dczia/Defcon25-Badge/README.md

## DC-Zia 2017
Badge - Arduino 101 Shield with LCD Display, Neopixel Lights and Cherry MX Blue Keyboard Buttons
