dczia/Defcon25-Badge/MechKeyboardShield/Hardware/Solid Model/dczia-badge.SLDASM

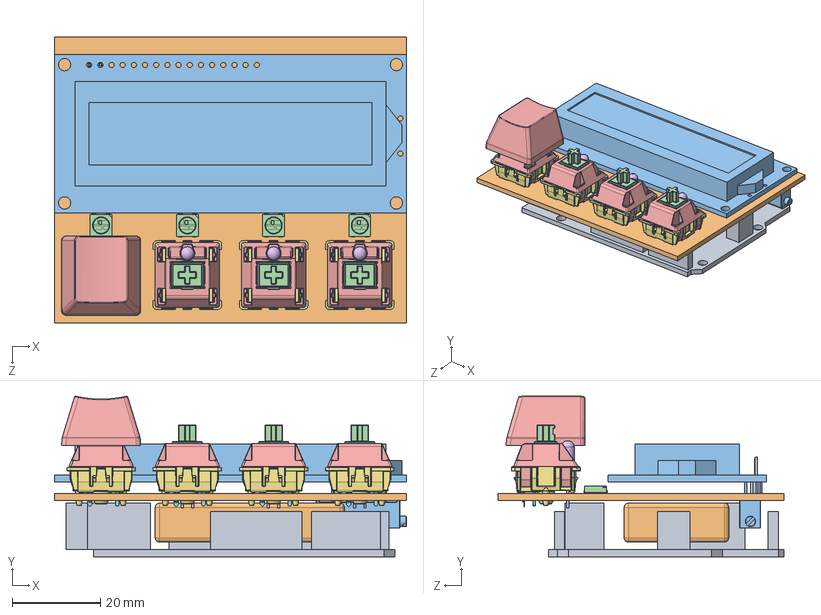
[picture p1: CAD file, 2017-08-07]
MechKeyboardShield/Hardware/Solid Model/dczia-badge.SLDASM
80.0 x 36.5 x 65.0 mm
MX 轴 按键 x 4
MX 轴 轴体 x 4
MX轴 无帽LED x 4
MX轴 轴体 底部 x 4
针脚 x 4
WS2812b Updated x 4
