dczia/Defcon25-Badge/MechKeyboardShield/Hardware/Solid Model/Parts/machanical-keyboard-keys-mx-key-switches-mx/MX 按键.SLDASM

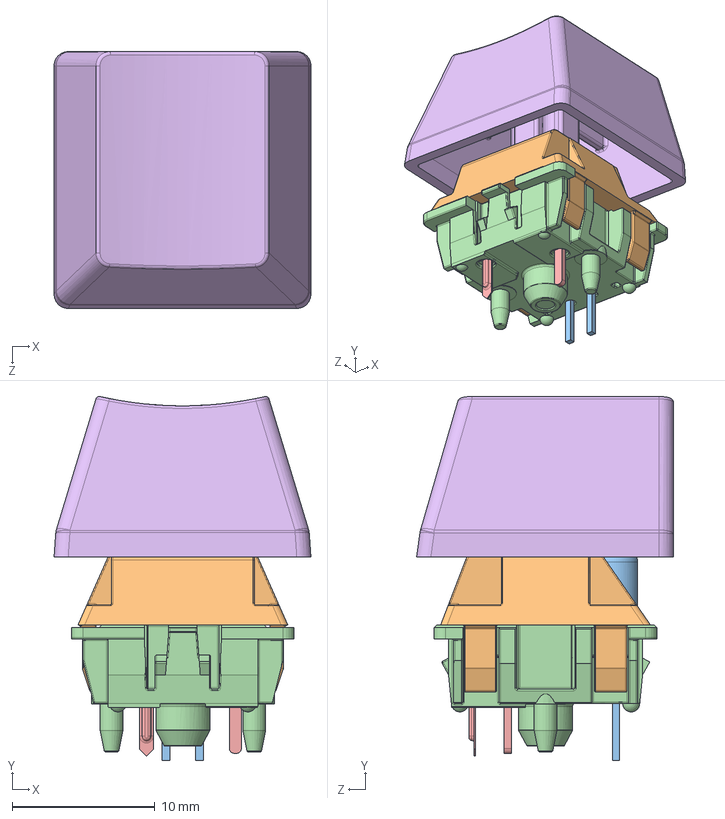
[picture p2: CAD file, 2017-08-07]
MechKeyboardShield/Hardware/Solid Model/Parts/machanical-keyboard-keys-mx-key-switches-mx/MX 按键.SLDASM
18.0 x 25.5 x 18.0 mm
MX 轴 按键
MX 轴 轴体
MX轴 无帽LED
MX轴 轴体 底部
针脚
MX 轴标准键帽
