dczia/Defcon25-Badge/MechKeyboardShield/Hardware/Overlay/Overlay.SLDPRT

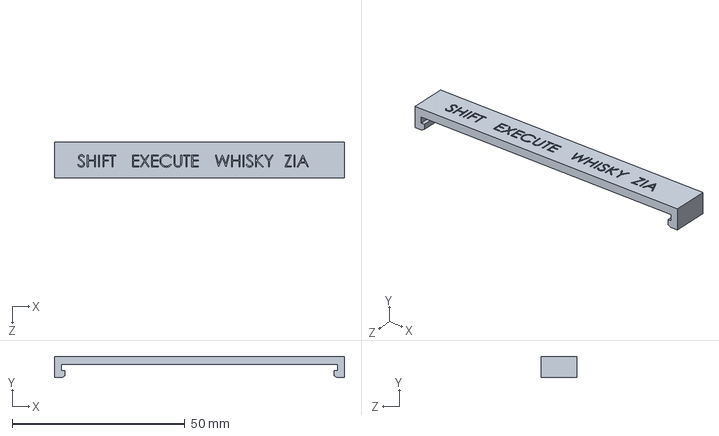
[picture p3: CAD file, 2017-08-07]
MechKeyboardShield/Hardware/Overlay/Overlay.SLDPRT
84.0 x 6.15 x 10.5 mm
