dczia/Defcon25-Badge/MechKeyboardShield/Hardware/Solid Model/Parts/1602 Display.SLDPRT

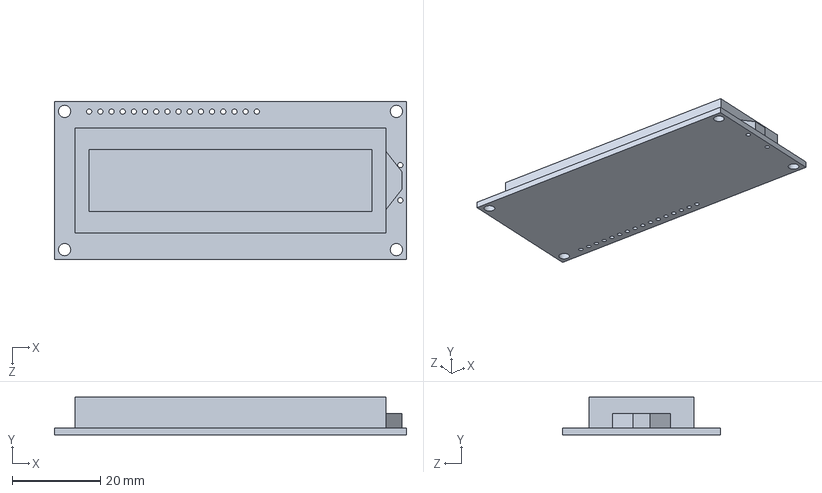
[picture p4: CAD file, 2017-08-07]
MechKeyboardShield/Hardware/Solid Model/Parts/1602 Display.SLDPRT
80.0 x 8.60 x 36.0 mm
