dczia/Defcon25-Badge/MechKeyboardShield/Hardware/Solid Model/Parts/machanical-keyboard-keys-mx-key-switches-mx/MX轴 无帽LED.SLDPRT

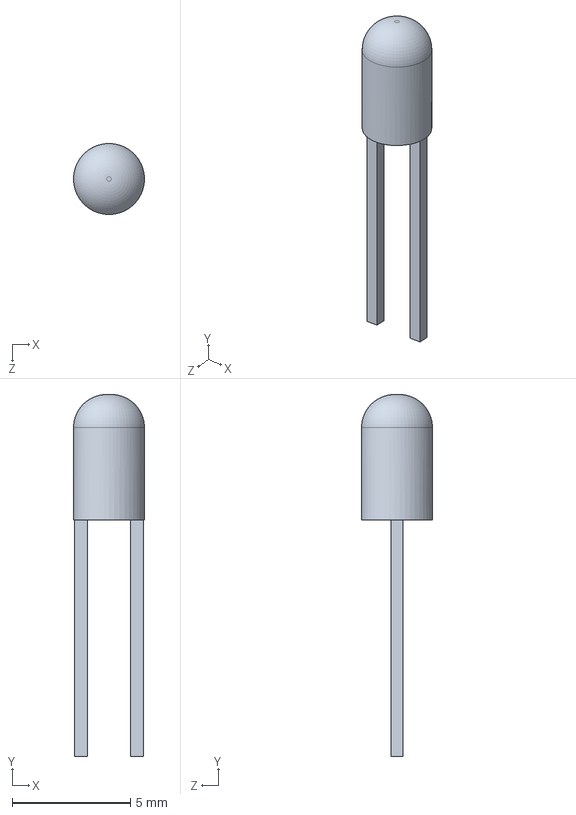
[picture p5: CAD file, 2017-08-07]
MechKeyboardShield/Hardware/Solid Model/Parts/machanical-keyboard-keys-mx-key-switches-mx/MX轴 无帽LED.SLDPRT
3.00 x 15.3 x 3.00 mm
