dczia/Defcon25-Badge/MechKeyboardShield/Hardware/Solid Model/Parts/standard-keycap-accurate-mx-keys/MX 轴标准键帽.STEP

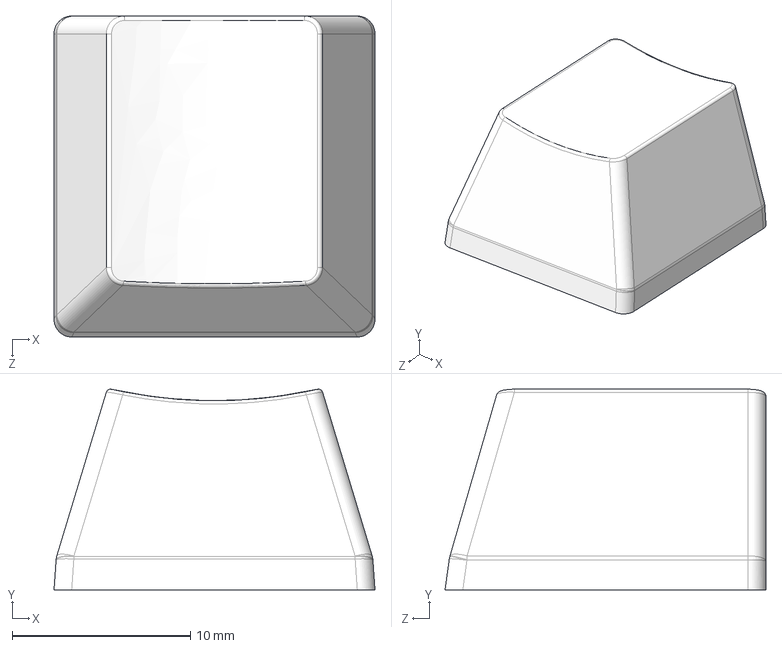
[picture p6: CAD file, 2017-08-07]
MechKeyboardShield/Hardware/Solid Model/Parts/standard-keycap-accurate-mx-keys/MX 轴标准键帽.STEP
18.0 x 11.3 x 18.0 mm
