dczia/Defcon25-Badge/MechKeyboardShield/Hardware/Solid Model/Parts/ws2812b-rgb-led-adafruit-neopixel/WS2812_RGB_LED_updated.stp

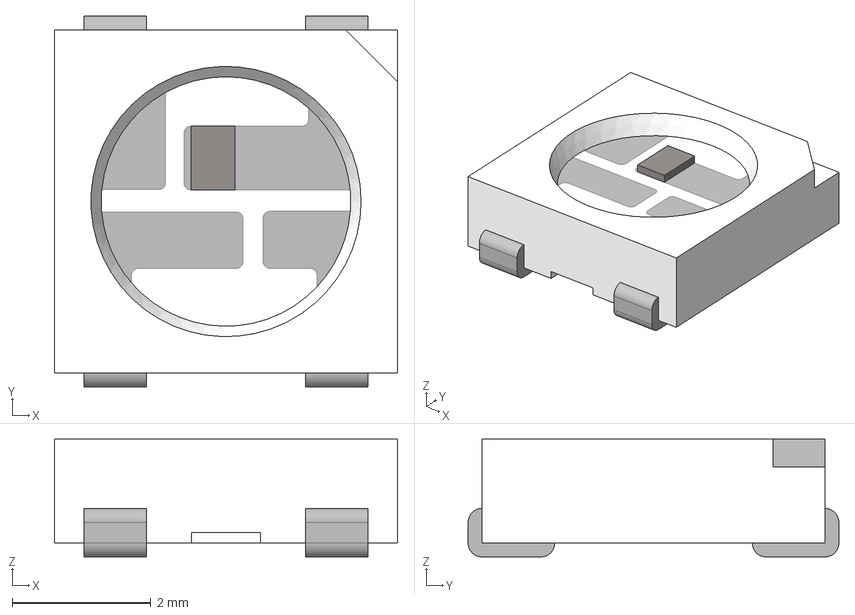
[picture p7: CAD file, 2017-08-07]
MechKeyboardShield/Hardware/Solid Model/Parts/ws2812b-rgb-led-adafruit-neopixel/WS2812_RGB_LED_updated.stp
4.95 x 5.35 x 1.70 mm
