dczia/Defcon25-Badge/MechKeyboardShield/Hardware/Solid Model/ButtonHolder.SLDPRT

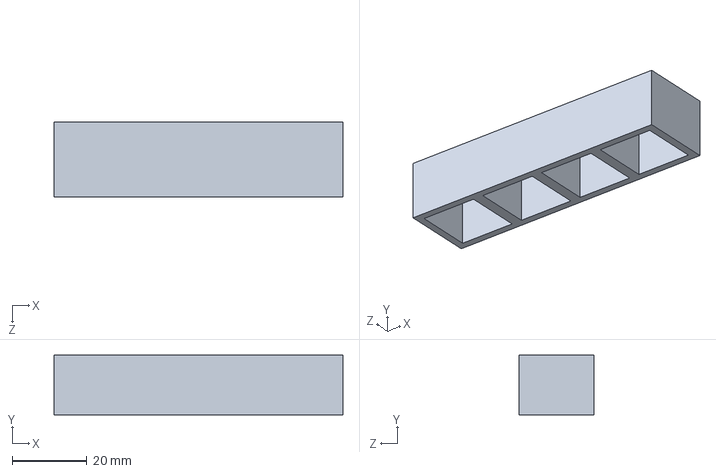
[picture p8: CAD file, 2017-08-07]
MechKeyboardShield/Hardware/Solid Model/ButtonHolder.SLDPRT
77.2 x 16.0 x 20.0 mm
