dczia/Defcon25-Badge/MechKeyboardShield/Hardware/Solid Model/Parts/2.54X2_pinheader_male.SLDPRT

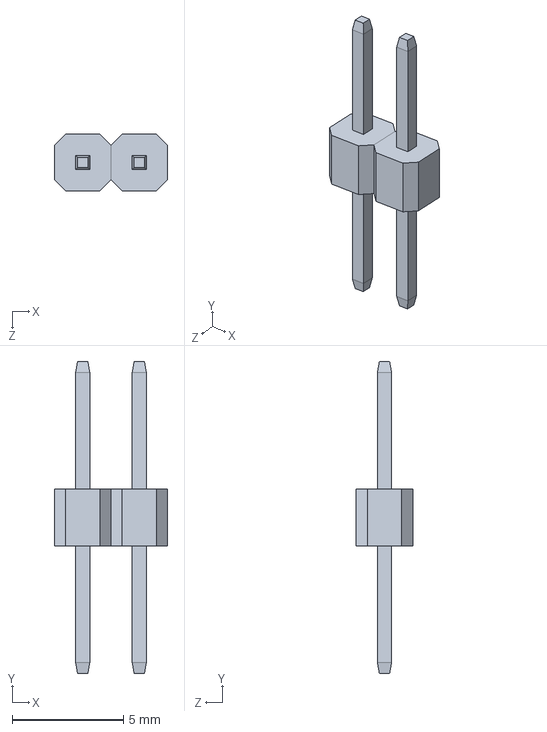
[picture p9: CAD file, 2017-08-07]
MechKeyboardShield/Hardware/Solid Model/Parts/2.54X2_pinheader_male.SLDPRT
5.08 x 14.0 x 2.54 mm
