dczia/Defcon25-Badge/MechKeyboardShield/Hardware/Solid Model/Parts/ws2812b-rgb-led-adafruit-neopixel/WS2812b Updated.sldprt

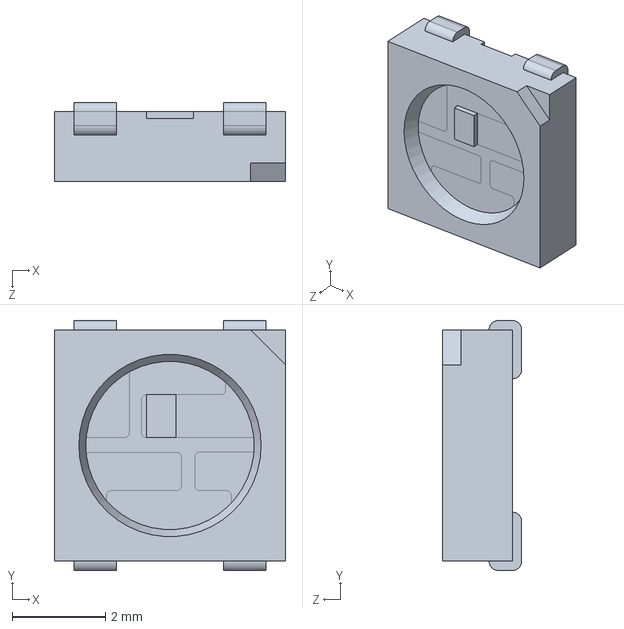
[picture p10: CAD file, 2017-08-07]
MechKeyboardShield/Hardware/Solid Model/Parts/ws2812b-rgb-led-adafruit-neopixel/WS2812b Updated.sldprt
4.95 x 5.35 x 1.70 mm
