dczia/Defcon25-Badge/MechKeyboardShield/Hardware/Solid Model/Parts/arduino-101.SLDPRT

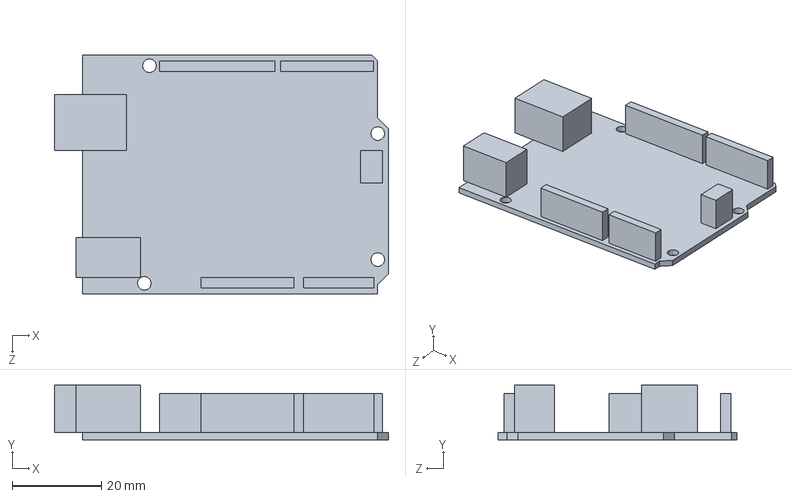
[picture p11: CAD file, 2017-08-07]
MechKeyboardShield/Hardware/Solid Model/Parts/arduino-101.SLDPRT
74.8 x 12.2 x 53.5 mm
