dczia/Defcon25-Badge/MechKeyboardShield/Hardware/Solid Model/Parts/machanical-keyboard-keys-mx-key-switches-mx/MX轴 轴体 底部.SLDPRT

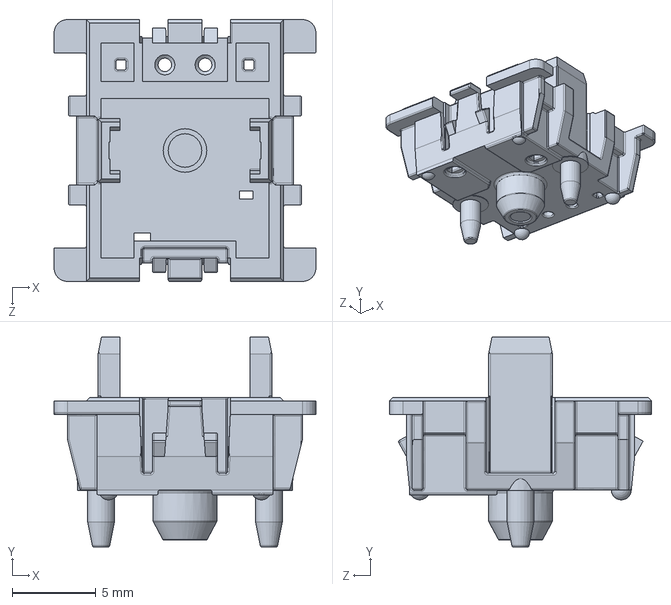
[picture p12: CAD file, 2017-08-07]
MechKeyboardShield/Hardware/Solid Model/Parts/machanical-keyboard-keys-mx-key-switches-mx/MX轴 轴体 底部.SLDPRT
15.6 x 12.5 x 15.6 mm
