dczia/Defcon25-Badge/MechKeyboardShield/Hardware/Solid Model/Parts/3P_TrimPot.stp

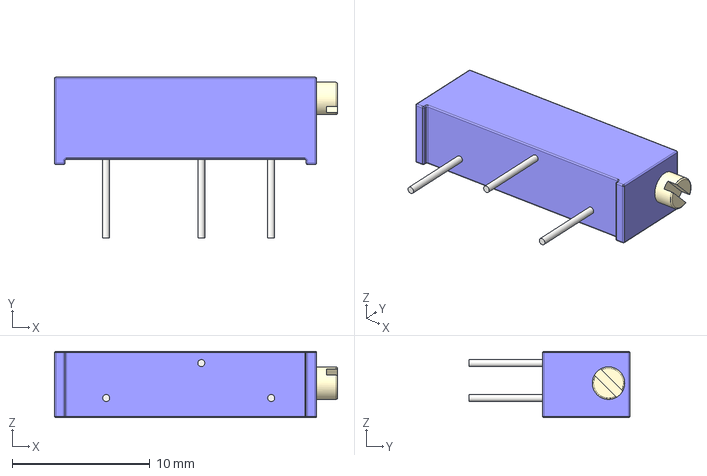
[picture p13: CAD file, 2017-08-07]
MechKeyboardShield/Hardware/Solid Model/Parts/3P_TrimPot.stp
20.6 x 11.7 x 4.83 mm
