dczia/Defcon25-Badge/MechKeyboardShield/Hardware/Solid Model/Parts/machanical-keyboard-keys-mx-key-switches-mx/MX 轴 轴体.SLDPRT

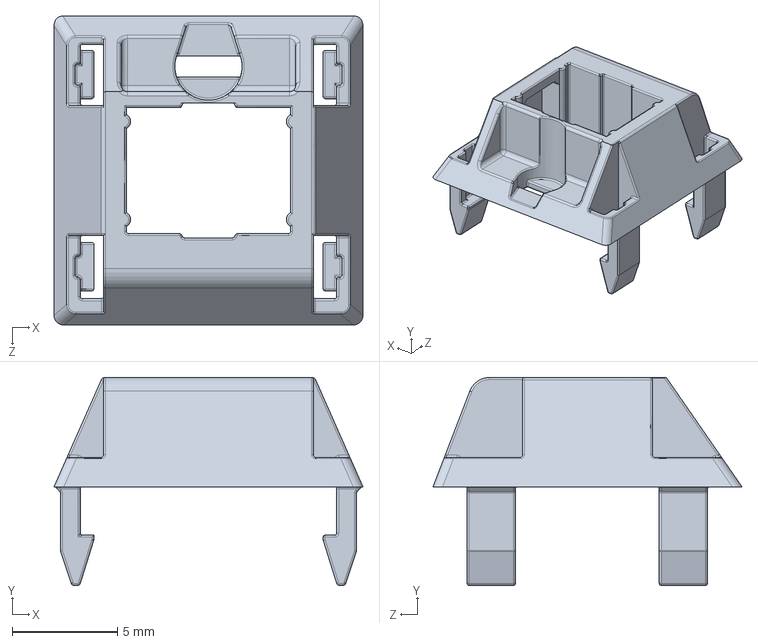
[picture p14: CAD file, 2017-08-07]
MechKeyboardShield/Hardware/Solid Model/Parts/machanical-keyboard-keys-mx-key-switches-mx/MX 轴 轴体.SLDPRT
14.7 x 9.90 x 14.7 mm
