dczia/Defcon25-Badge/MechKeyboardShield/Hardware/Solid Model/Parts/800mAh Battery.SLDPRT

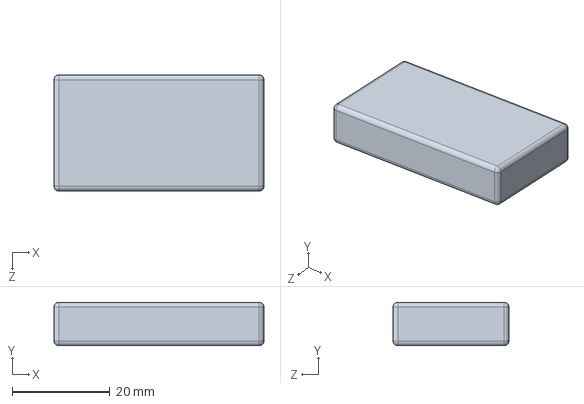
[picture p15: CAD file, 2017-08-07]
MechKeyboardShield/Hardware/Solid Model/Parts/800mAh Battery.SLDPRT
43.0 x 8.89 x 23.8 mm
