dczia/Defcon25-Badge/MechKeyboardShield/Hardware/Solid Model/Parts/machanical-keyboard-keys-mx-key-switches-mx/MX 轴 按键.SLDPRT

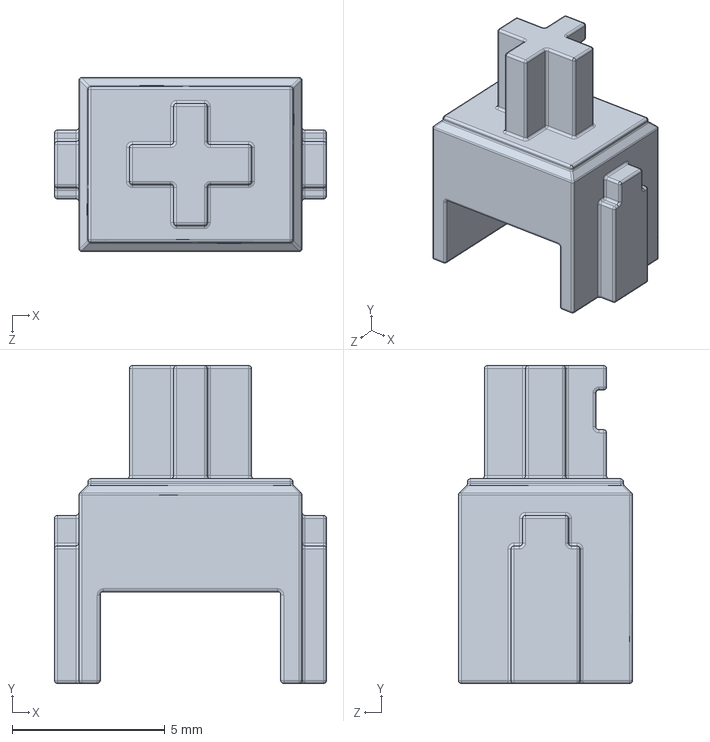
[picture p16: CAD file, 2017-08-07]
MechKeyboardShield/Hardware/Solid Model/Parts/machanical-keyboard-keys-mx-key-switches-mx/MX 轴 按键.SLDPRT
8.90 x 10.4 x 5.70 mm
