dczia/Defcon25-Badge/(list of files, cad)

Other CAD files:
MechKeyboardShield/Hardware/Solid Model/Shield PCB.sldprt
MechKeyboardShield/Hardware/Overlay/Overlay.STL
MechKeyboardShield/Hardware/Solid Model/ButtonHolder.STL
MechKeyboardShield/Hardware/Solid Model/Parts/3P_TrimPot.SLDPRT
MechKeyboardShield/Hardware/Solid Model/Parts/standard-keycap-accurate-mx-keys/MX 轴标准键帽.SLDPRT
MechKeyboardShield/Hardware/Solid Model/Parts/standard-keycap-accurate-mx-keys/MX 轴标准键帽.STL
MechKeyboardShield/Hardware/Solid Model/Parts/ws2812b-rgb-led-adafruit-neopixel/WS2812_RGB_LED_Updated.igs
MechKeyboardShield/Hardware/Solid Model/Parts/ws2812b-rgb-led-adafruit-neopixel/WS2812b Updated.prt
MechKeyboardShield/Hardware/Solid Model/Parts/ws2812b-rgb-led-adafruit-neopixel/WS2812b updated.x_t
