dczia/Defcon25-Badge/MechKeyboardShield/Hardware/DCZia MechKeyBadge Schematic.pdf

### 16x2 LCD USB

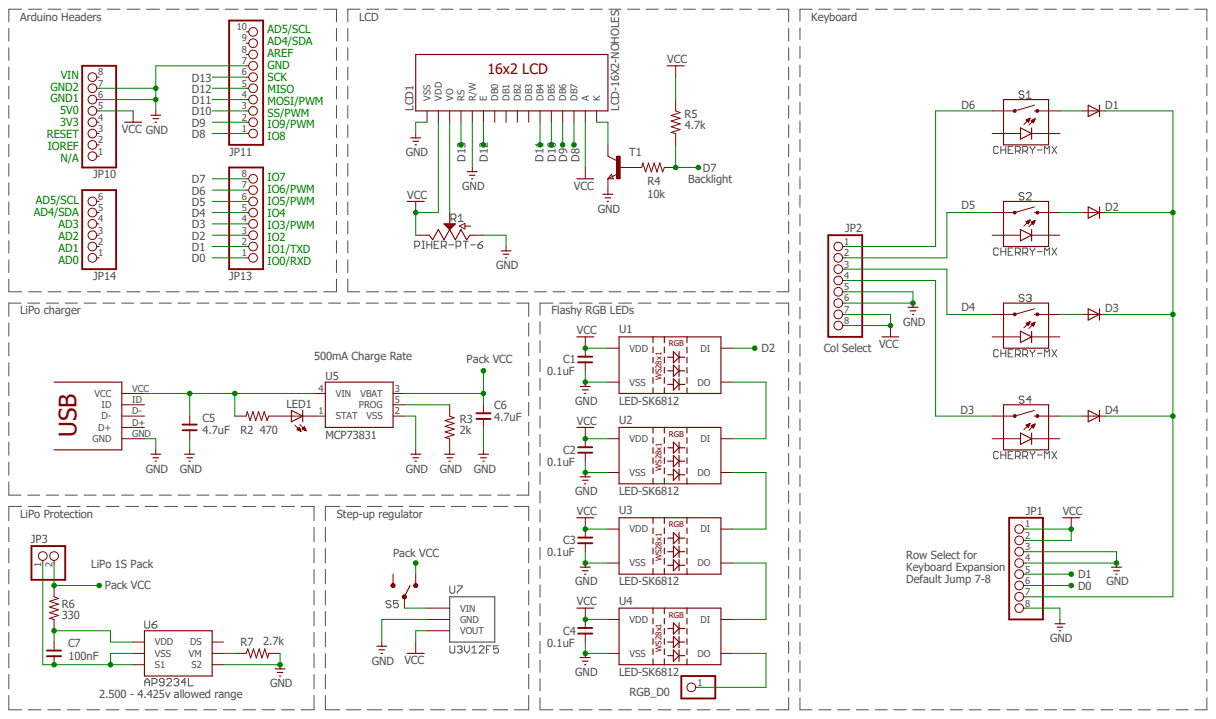
[picture p19: page 1]

Pack VCC 500mA Charge Rate
