dczia/Defcon25-Badge/MechKeyboardShield/Hardware/DCZiaMechKeyBadge-Bottom-plus-Silk.pdf

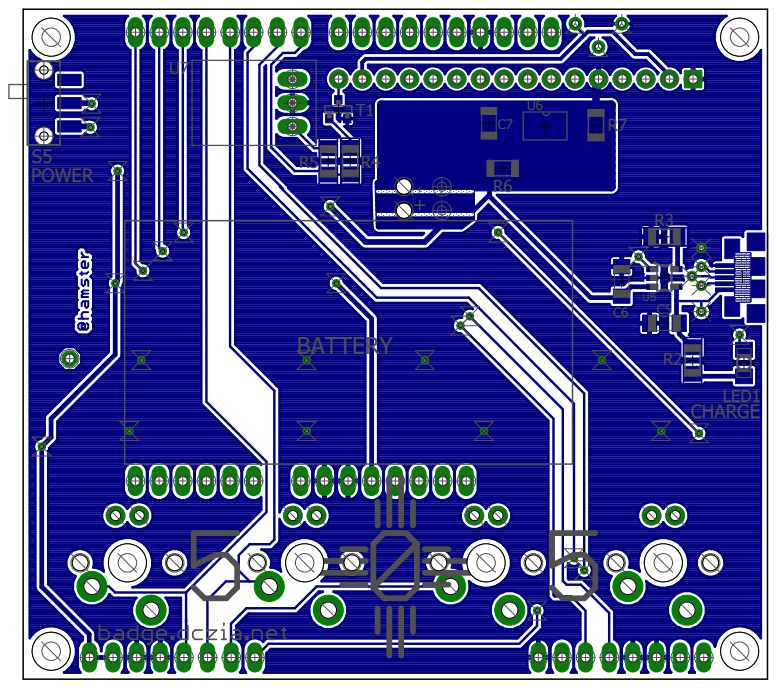
[picture p20: page 1]
