dczia/Defcon25-Badge/MechKeyboardShield/Hardware/DCZiaMechKeyBadge-Top-plus-Silk.pdf

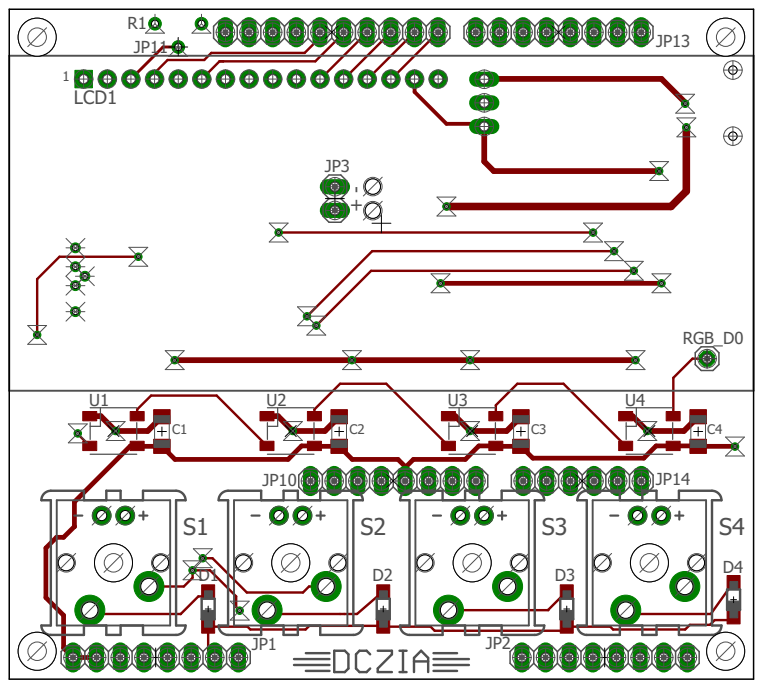
[picture p21: page 1]
