dczia/Defcon25-Badge/MechKeyboardShield/Hardware/DCZia MechKeyBadge.brd

## EAGLE design MechKeyboardShield/Hardware/DCZia MechKeyBadge.brd (2017-08-07)

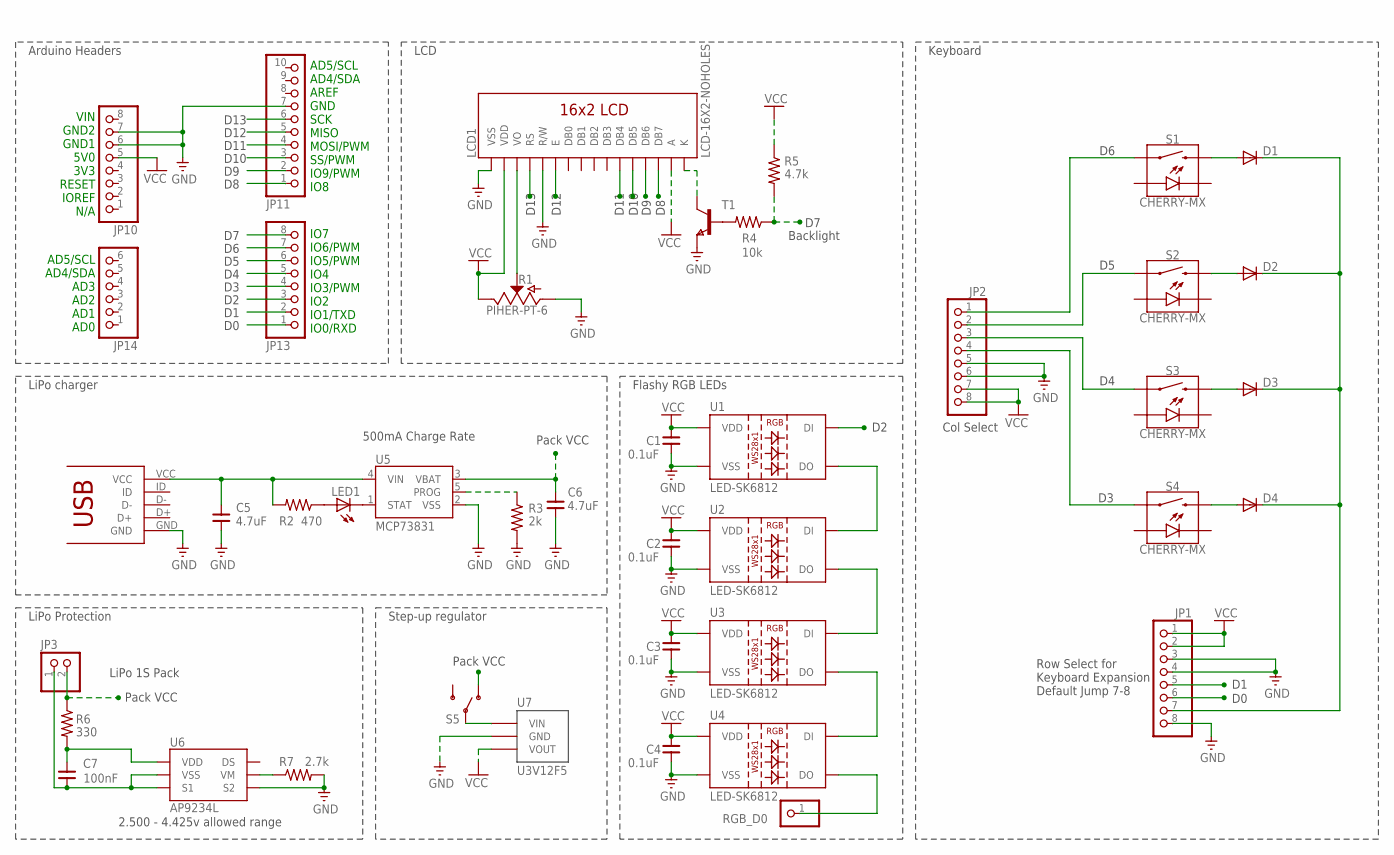
[picture p22: schematic DCZia MechKeyBadge.sch]

Parts:
C1, C2, C3, C4: 0.1uF; 1206
C5, C6: 4.7uF; 1206
C7: 100nF; 1206
D1, D2, D3, D4: DIODE-SOD123; SOD123
JP1, JP2, JP10, JP13: PINHD-1X8; 1X08
JP3: PINHD-1X2; 1X02
JP11: PINHD-1X10; 1X10
JP14: PINHD-1X6; 1X06
LCD1: LCD-16X2-NOHOLES; LCD-16X2
LED1: LEDSMT1206; 1206
R1: PIHER-PT-6
R2: 470; R1206
R3: 2k; R1206
R4: 10k; R1206
R5: 4.7k; R1206
R6: 330; R1206
R7: 2.7k; R1206
RGB_D0: PINHD-1X1; 1X01
S1, S2, S3, S4: CHERRY-MX; CHERRY-MX-LED
S5: SWITCH-SPDTSMD; SWITCH_SPDT_SMD
T1: NPNSOT23; SOT-23
U1, U2, U3, U4: LED-SK6812; SK6812
U5: MCP73831; SOT23-5
U6: AP9234L; U-DFN2535-6
U7: U3V12F5; POLOLU_REGULATOR
U$1: 10118192-0001LF

Connections:
D0: JP1.6, JP13.1
D1: JP1.5, JP13.2
D2: JP13.3, U1.P$2 (DI)
D3: JP2.4, JP13.4, S4.S1 (1)
D4: JP2.3, JP13.5, S3.S1 (1)
D5: JP2.2, JP13.6, S2.S1 (1)
D6: JP2.1, JP13.7, S1.S1 (1)
D7: JP13.8, R4.1, R5.2
D8: JP11.1, LCD1.14 (DB7)
D9: JP11.2, LCD1.13 (DB6)
D10: JP11.3, LCD1.12 (DB5)
D11: JP11.4, LCD1.11 (DB4)
D12: JP11.5, LCD1.6 (E)
D13: JP11.6, LCD1.4 (RS)
GND: C1.P$1 (1), C2.P$1 (1), C3.P$1 (1), C4.P$1 (1), C5.P$1 (1), C6.P$1 (1), JP1.3, JP1.4, JP1.8, JP2.5, JP2.6, JP10.6, JP10.7, JP11.7, LCD1.1 (VSS), LCD1.5 (R/W), R1.P$1 (1), R3.2, R7.2, T1.2 (E), U1.P$1 (VSS), U2.P$1 (VSS), U3.P$1 (VSS), U4.P$1 (VSS), U5.2 (VSS), U6.S2, U7.2 (GND), U$1.GND
unnamed: LCD1.3 (VO), R1.P$2 (2)
unnamed: U1.P$4 (DO), U2.P$2 (DI)
unnamed: U2.P$4 (DO), U3.P$2 (DI)
unnamed: U3.P$4 (DO), U4.P$2 (DI)
unnamed: D4.A, S4.S2 (2)
unnamed: D1.A, S1.S2 (2)
unnamed: D2.A, S2.S2 (2)
unnamed: D3.A, S3.S2 (2)
unnamed: LED1.A, R2.1
unnamed: LED1.C, U5.1 (STAT)
unnamed: R3.1, U5.5 (PROG)
unnamed: RGB_D0.1, U4.P$4 (DO)
unnamed: D1.C, D2.C, D3.C, D4.C, JP1.7
unnamed: R4.2, T1.3 (B)
unnamed: LCD1.16 (K), T1.1 (C)
unnamed: S5.2, U7.3 (VIN)
unnamed: C5.P$2 (2), R2.2, U5.4 (VIN), U$1.VCC
unnamed: R7.1, U6.VM
unnamed: C7.P$2 (2), JP3.1, U6.S1, U6.VSS
unnamed: C7.P$1 (1), R6.2, U6.VDD
PACK_VCC: C6.P$2 (2), JP3.2, R6.1, S5.1 (O), U5.3 (VBAT)
VCC: C1.P$2 (2), C2.P$2 (2), C3.P$2 (2), C4.P$2 (2), JP1.1, JP1.2, JP2.7, JP2.8, JP10.5, LCD1.2 (VDD), LCD1.15 (A), R1.P$3 (3), R5.1, U1.P$3 (VDD), U2.P$3 (VDD), U3.P$3 (VDD), U4.P$3 (VDD), U7.1 (VOUT)

Notes on the sheet:
VIN GND2 GND1 5V0 3V3 RESET IOREF N/A
AD5/SCL AD4/SDA AREF GND SCK MISO MOSI/PWM SS/PWM IO9/PWM IO8
IO7 IO6/PWM IO5/PWM IO4 IO3/PWM IO2 IO1/TXD IO0/RXD
AD5/SCL AD4/SDA AD3 AD2 AD1 AD0
D13
D12
D11
D10
Row Select for Keyboard Expansion Default Jump 7-8
Col Select
LiPo charger
Arduino Headers
Backlight
LCD
Flashy RGB LEDs
Keyboard
LiPo 1S Pack
Pack VCC
2.500 - 4.425v allowed range
LiPo Protection
500mA Charge Rate
Step-up regulator

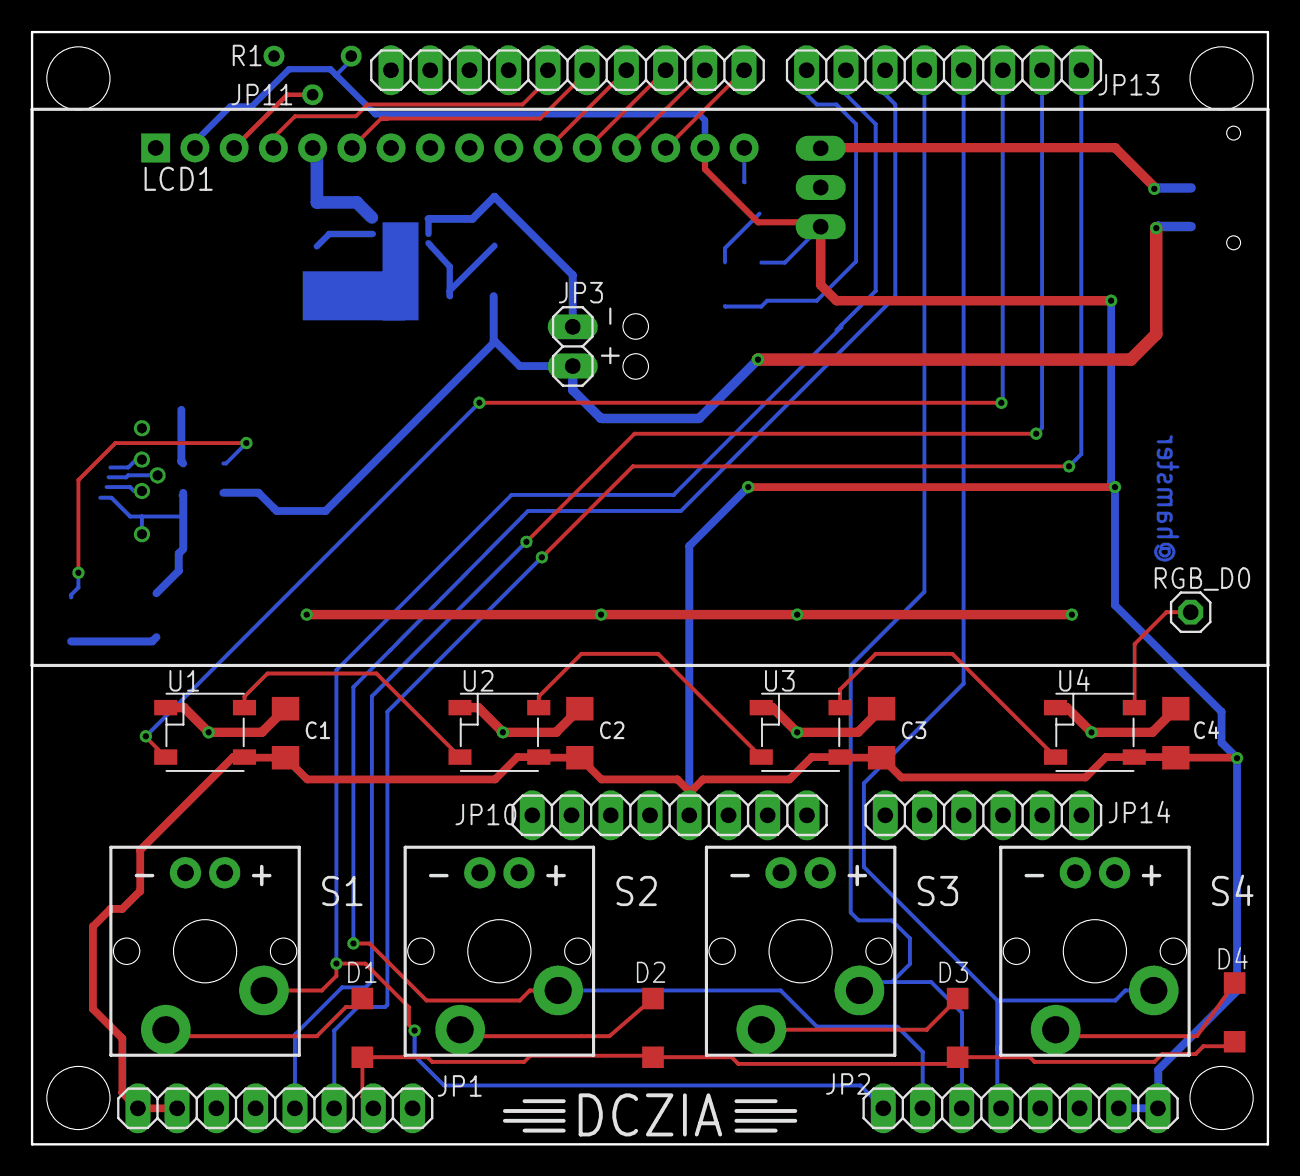
[picture p23: board DCZia MechKeyBadge.brd from above]

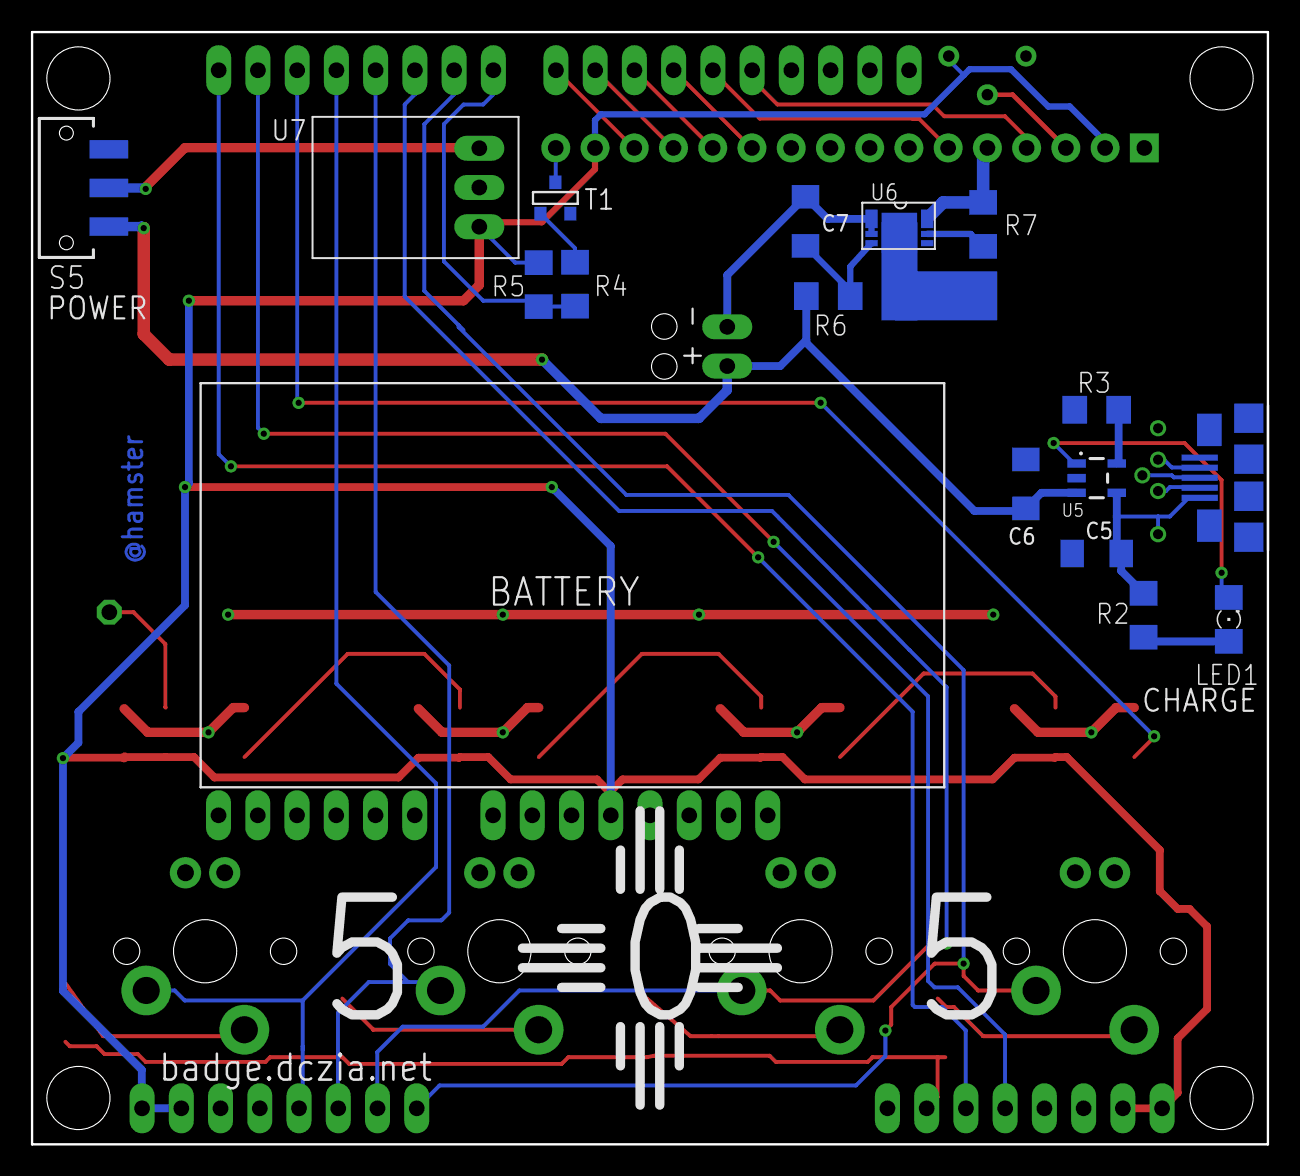
[picture p24: board DCZia MechKeyBadge.brd from below]

Board: 2 copper layers, 80.0 x 72.0 mm, 42 parts (16 on the bottom side), 37 nets.
