dczia/Defcon25-Badge/(commit log)

2017-08-06 First commit containing all that's required to get the DCZia 2017 badge off the ground.
2017-08-07 Removed library files so Arduino won't be confused
    [DCZia2017.ino]
2017-08-07 Adding hardware files Moved everything to a MechKeyboardShield directory
    [1602 Display.SLDPRT, 2.54X2_pinheader_male.SLDPRT, 3P_TrimPot.SLDPRT, 3P_TrimPot.stp, 800mAh Battery.SLDPRT, ButtonHolder.SLDPRT, ButtonHolder.STL, DCZia MechKeyBadge.brd]
