dczia/Defcon25-Badge/(notices)

Notices in the files:
parts and their libraries:
SparkFun-IC-Power: Licensing: Creative Commons ShareAlike 4.0 International - https://creativecommons.org/licenses/by-sa/4.0
supply0: Copyright (C) 2007, Bob Starr
